davidorlian/smart-shabbat-switch/docs/project-book/Smart_Shabbat_Switch_Project_Book_HE.pdf

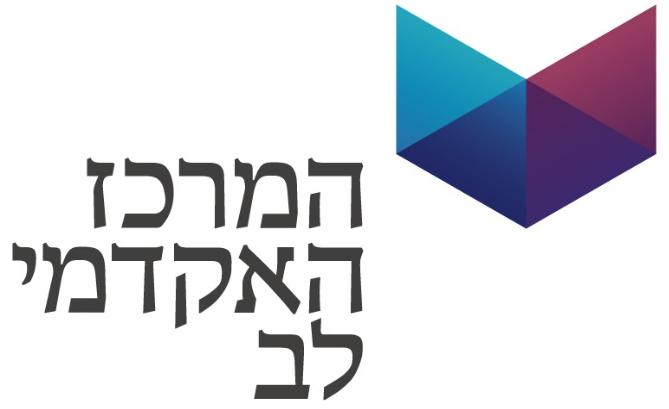
[picture p1: figure]

# הפקולטה להנדסה ומדעי המחשב

# החוג להנדסת חשמל ואלקטרוניקה

# פרויקט גמר באלקטרוניקה

# מתג שבת חכם

# Smart Shabbat Switch

## מגישים: ברק אשואל ודוד אורליאן שבט תשפ"ו מנחה: לירון בחכמה ירושלים

# תוכן עניינים

רשימת איורים 3 |
רשימת טבלאות 4 |
תקציר5 |
.1 מבוא 7 |
.2 רקע תיאורטי וסקירת ספרות 8 |
.3 פיתוח ושיטות10 |
.4 תוצאות 21 |
.5 מסקנות וסיכום 22 |
נספח א24 |
נספח ב25 |
נספח ג 26 |
מקורות 27 |

# רשימת איורים

19 | AC-DC 5V | ממיר | :3.7 | איור

# רשימת טבלאות

טבלה :3.1 רשתות מתח ואותות מרכזיים 12 |
טבלה :3.2 P328ATmega פינים בשימוש13 |
טבלה :3.3 חיבורים חיצוניים 14 |
טבלה נספח ב': תרחישי קצה 25 |

# תקציר

שימוש במתגי קיר להפעלת צרכני חשמל הוא חלק בלתי נפרד מההתנהלות היומיומית בבתים ובמרחבים ציבוריים. במצבים שונים, לחיצה מקרית על המתג )למשל ע״י ילדים, אורחים או מתוך הרגל( עלולה לשנות את מצב התאורה או המכשיר החשמלי באופן שאינו רצוי. עבור ציבור שומר י השבת, שינוי כזה במהלך השבת יוצר קושי ייחודי: הוא עלול לכפות מצב חדש, ובמהלך השבת לא ניתן לתקן את השינוי ולהחזיר את המצב לקדמותו באופן מכני. פתרונות קיימים כגון כיסויים מכניים למתגים מספקים מענה חלקי בלבד, משום שהם מצריכים התקנה והסרה ידנית בכל שבת, פוגעים באסתטיקה, ואינם מספקים חסימה אמינה לאורך זמן. מטרת פרויקט זה היא פיתוח "מתג שבת חכם" – יחידת קצה אלקטרונית המונעת שינוי לא רצוי של מצב הצרכן במהלך השבת באמצעות נעילה אלקטרונית של מתג הקיר.

המערכת שפותחה מבוססת על מיקרו־בקר ומשלבת מנגנון דגימת מצב הצרכן באמצעות מעגל חישה לנוכחות מתח רשת )AC), יחד עם שני ממסרים אלקטרומכניים. בעת קבלת פקודת מעבר למצב שבת, היחידה דוגמת את מצב הצרכן )דלוק או כבוי(, מנטרלת את השפעת מתג הקיר וקובעת את מצב ההזנה כך שהמצב שנדגם יישמר למשך מצב השבת . המתג פועל כיחידת קצה הנשלטת ע״י יחידת בקרה מרכזית, ומתקשר עם יחידת הבקרה באמצעות תקשורת אלחוטית, הכוללת מנגנון אישור קבלה )ACK )להבטחת אמינות הפקודות.

תוצאות הבדיקות הראו כי במצב שבת נשמר מצב הצרכן באופן עקבי, ללא תלות בשינויים פיזיים במתג הקיר. הן בתרחיש שבו הצרכן נכנס למצב שבת כשהוא דלוק והן כאשר נכנס כבוי, הודגם כי לחיצה על המתג במהלך השבת אינה גורמת לשינוי במצב הצרכן. בנוסף, נבחנה התנהגות המערכת במצבי קצה כגון הפסקות חשמל וחזרת מתח, ונמצא כי היחידה מתאוששת באופן צפוי ובטוח, תוך שמירה על רציפות לוגית של מצב הפעולה.

הפרויקט תורם פתרון פשוט, אמין ויישומי למניעת שינוי לא רצוי של מצב צרכן חשמלי במצב שבת באמצעות נעילה אלקטרונית פעילה. אף שהמערכת פותחה כדי להתמודד עם בעיה הלכתית לציבור שומר השבת, העיקרון ההנדסי שעליו היא מבוססת – נעילת השפעת המתג ושימור מצב הצרכן – מאפשר להכליל את הפתרון גם למצבים שבהם נדרשת יציבות תפעולית, כגון במקומות ציבוריים שבהם שינוי לא מכוון של תאורה מהווה בעיה תפקודית.

# Abstract

Wall switches are a routine way to control lighting and electrical loads in homes and public spaces. In various situations, an accidental press (e.g., by children, guests, or out of habit) can change the state of a light or appliance unintentionally. For Sabbath-observant users, such a change during Shabbat creates a unique difficulty: it may impose a new state, and the user cannot directly “undo” the change by operating the switch during Shabbat. Existing solutions such as mechanical switch covers provide only a partial answer, as they require manual installation and removal every week, affect aesthetics, and do not guarantee reliable blocking over time. The goal of this project is to develop a “Smart Shabbat Switch” – an electronic end-unit that prevents undesired changes during Shabbat by electronically locking the effect of the wall switch.

The developed system is microcontroller-based and samples the load state using an AC mains presence sensing circuit, together with two electromechanical relays. Upon receiving a command to enter Shabbat mode, the unit samples whether the load is ON or OFF, neutralizes the effect of the wall switch, and sets the supply path so that the sampled state is maintained throughout Shabbat. The switch operates as an end-unit controlled by a central control unit and communicates with it wirelessly, including an acknowledgment (ACK) mechanism to improve command reliability.

Test results showed that, in Shabbat mode, the load state is maintained consistently regardless of physical changes at the wall switch. Both when entering Shabbat mode with the load ON and when entering it with the load OFF, pressing the switch during Shabbat did not change the load state. In addition, edge cases such as power outages and power restoration were evaluated, and the unit was found to recover in a predictable and safe manner while maintaining logical continuity of its operating state.

This project delivers a simple, reliable, and practical solution for preventing undesired changes of an electrical load during Shabbat via active electronic locking. Although the system was designed to address a halachic challenge for Sabbath-observant users, its underlying engineering principle – locking the switch influence and preserving the load state – can be generalized to scenarios that require operational stability, such as public spaces where unintended lighting changes are a functional problem.

# .1 מבוא

מערכות חשמל ביתיות מהוות חלק בלתי נפרד מהתנהלות היומיום בבית המודרני. תאורה, מכשירי חשמל וצרכנים שונים מופעלים באמצעות מתגי קיר פשוטים, הנמצאים בשימוש תדיר ונגישים לכל דיירי הבית. עבור ציבור שומר י השבת, השימוש במערכות אלו מחייב תכנון מוקדם ויצירת מצב שבו פעולת החשמל נשמרת קבועה לאורך השבת, ללא צורך בהתערבות אנושית וללא שינוי בלתי רצוי של מצב המערכת .

במציאות הביתית, ובפרט בבתים שבהם מתגוררים ילדים או מתקיימת תנועת אורחים, קיים סיכון ממשי לשינוי בלתי־מכוון של מצב החשמל. ילדים עלולים ללחוץ על מתג מתוך סקרנות, משחק או חוסר מודעות, ואילו מבוגרים עשויים לשנות את מצב המתג מתוך הרגל, חוסר תשומת לב או הישענות מקרית על הקיר. פעולות אלו מתרחשות באופן טבעי ושגרתי, אך במהלך השבת הן עלולות לגרום לשינוי לא רצוי במצב התאורה או בצרכן החשמלי.

מעבר להיבט ההלכתי, מצבים אלו גורמים בעיקר לעגמת נפש ולפגיעה בכבוד השבת. שינוי פתאומי של תאורה או כיבוי מכשיר חשמלי במהלך השבת עלול להפר את האווירה השקטה והמתוכננת של היום, ליצור תחושת חוסר נוחות ולפגוע בתחושת השליטה והשלווה של בני הבית. עבור משפחות רבות, השבת אינה רק מסגרת הלכתית אלא גם זמן של רוגע, משפחתיות וכבוד, וכל תקלה או שינוי בלתי רצוי במערכת החשמל עלולים לפגוע בחוויה זו.

קיימים פתרונות פשוטים המבוססים על אמצעים מכניים, כגון תליית חוצץ פיזי או כיסוי למתג הקיר לפני כניסת השבת, במטרה למנוע לחיצה ישירה על המתג. עם זאת, פתרונות אלו מספקים מענה חלקי בלבד, שכן הם תלויים בזכירה ובהיערכות מוקדמת של המשתמש בכל ערב שבת ואינם פועלים באופן אוטונומי. בנוסף, חוצץ פיזי אינו מונע באופן מוחלט שינוי מצב המתג: ילדים עלולים לשחק בו, להסירו או להזיזו ממקומו, ואף מבוגרים עשויים להסירו מתוך חוסר תשומת לב. מגבלות אלו פוגעות באמינות הפתרון ומגבירות את הסיכון לשינוי לא מתוכנן של מצב החשמל, על כל ההשלכות הנלוות לכך.

על רקע זה, מטרת העבודה בפרויקט זה היא לפתח פתרון טכנולוגי ייעודי בדמות "מתג שבת חכם ", אשר ימנע שינוי בלתי־מכוון של מצב צרכני החשמל במהלך השבת, גם במקרה של לחיצה פיזית על מתג הקיר. המתג נועד לפעול כחלק ממערכת מתוכננת מראש, אך גם כיחידת קצה עצמאית המספקת שכבת הגנה ברורה ויעילה מפני טעויות אנוש. בכך, הפרויקט מתמקד בבעיה יומיומית ומעשית המוכרת לכל בית שומר שבת, ולא רק בהיבט תאורטי או טכני .

הפתרון שפותח במסגרת הפרויקט מבוסס על נעילה אלקטרונית של מצב המתג בזמן השבת, כך שמצב הצרכן החשמלי נשמר כפי שהיה עם כניסת השבת ואינו משתנה כתוצאה מפעולה פיזית על המתג. גישה זו מבטלת את התלות בזהירות המשתמשים או בהסברה מוקדמת לילדים ולאורחים, ומאפשרת התנהלות טבעית בבית ללא חשש מתמיד משינוי בלתי רצוי של מצב החשמל. בכך, המערכת תורמת לשמירה על רציפות השבת, על האווירה הביתית ועל כבודה של השבת, ולא רק על עמידה טכנית בכללים .

חשיבותו הציבורית של הפרויקט באה לידי ביטוי בשיפור איכות החיים של הציבור שומר השבת. המערכת מעניקה תחושת ביטחון ושקט נפשי, מפחיתה מצבי אי־ודאות ומאפשרת ניהול ביתי רגוע גם בסביבה שבה מתגי החשמל נגישים לכלל הדיירים והאורחים. היא מצמצמת מצבים של מתח, אכזבה או פגיעה באווירת השבת, ומאפשרת לבני הבית להתמקד במשמעותו הרוחנית והמשפחתית של היום .

מעבר לסביבה הביתית, ל "מתג שבת חכם" קיימת תרומה גם למרחבים ציבוריים שאינם פרטיים, כגון אולמות כנסים, אתרי אירועים, מרכזים קהילתיים ומבני ציבור. במקומות אלו מתגי חשמל ותאורה נגישים לעיתים לקהל רחב, וקיים סיכון לשינוי מצב החשמל עקב לחיצה לא מכוונת, הישענות מקרית או חוסר מודעות של משתמשים שונים. שינוי כזה עלול לגרום להפרעה לאירוע, לפגיעה ברצף הפעילות ולעגמת נפש בקרב המשתתפים. האפשרות לנעול את מצב המתג מראש מאפשרת שמירה על יציבות ורציפות תפעולית, ללא תלות בנוכחות איש תפעול סמוך לכל מתג.

לסיכום, פרויקט "מתג שבת חכם" נולד מתוך צורך ביתי וציבורי ממשי: מניעת שינוי בלתי־מכוון של מצב החשמל בסביבה שבה מתגי הקיר נגישים למשתמשים רבים. באמצעות פתרון טכנולוגי פשוט, ברור ויעיל, הפרויקט מציע מענה מעשי לבעיה יומיומית נפוצה, תורם למניעת עגמת נפש ולשמירה על כבוד השבת, ומאפשר יצירת סביבה ביתית וציבורית רגועה, מבוקרת ומכבדת יותר. בכך, הוא מדגים כיצד תכנון הנדסי רגיש יכול לתת מענה מדויק לאתגר אנושי-ערכי ולשפר באופן ממשי את חוויית החיים .

# .2 רקע תיאורטי וסקירת ספרות

## 2.1 מוצרים קיימים בשוק

### 2.1.1 מגני מתגים קיימים בשוק

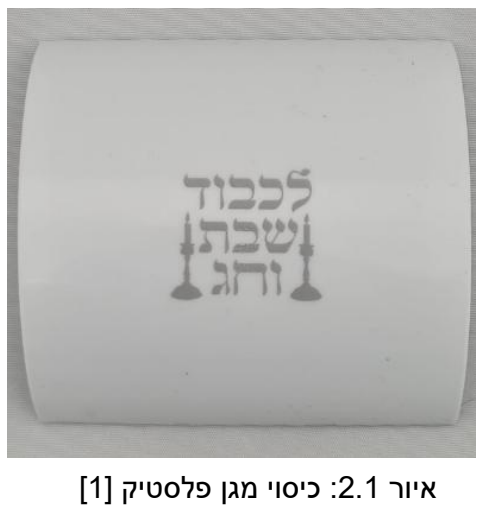
[picture p2: figure]
איור :2.1 כיסוי מגן פלסטיק ]1[

אחד הפתרונות הנפוצים והפשוטים ביותר למניעת לחיצה מקרית על מתג קיר הוא שימוש במגן מתג פיזי. בפועל, ברוב המקרים מדובר בכיסוי פלסטיק המותקן על גבי מסגרת המתג )איור 2.1( , ויוצר מחסום מכני המקטין את הנגישות הישירה ללחצן. הכיסוי מיועד למנוע לחיצה אקראית הנגרמת מהיסח דעת, משחק ילדים, או הישענות מקרית על הקיר, ובכך לצמצם שינוי לא רצוי במצב התאורה או הצרכן החשמלי המחובר.

יתרונו המרכזי של פתרון זה הוא פשטות: מדובר בהתקנה מהירה יחסית, ללא צורך בחיווט, ללא צורך בבקר, וללא שינוי במערכת החשמל הקיימת. עם זאת, מאחר שמדובר בפתרון פסיבי המבוסס על חסימה מכנית בלבד, הוא אינו "מבין" את מצב המערכת ואינו מבצע בקרה או נעילה אלקטרונית של המעגל. כלומר, הוא מנסה לצמצם את ההסתברות ללחיצה – אך אינו מבטיח שמצב הצרכן יישמר בפועל.

## 2.2 מגבלות המוצרים הקיימים

לאחר בחינת הפתרונות הרלוונטיים למניעת שינוי בלתי־מכוון של מתג קיר, ניתן להצביע על מספר מגבלות מהותיות – מגבלות שהפרויקט הנוכחי נועד לתת להן מענה ישיר.

- היערכות פיזית מבוזרת לפני שבת : פתרונות כיסוי דורשים התקנה/הצמדה פיזית לכל מתג בנפרד לפני שבת )ולעיתים גם הסרה לאחריה(. כלומר, ההגנה תלויה בטרחה חוזרת ובזכירה פר־מתג.
- אמינות מכנית מוגבלת: רכיב פלסטי נוטה לבלאי, שבר, התרופפות או נפילה לאורך זמן שימוש, ולכן אינו מספק יציבות תפעולית עקבית.
- פגיעות להתערבות משתמשים ועקיפה: הסרה אינטואיטיבית )אורחים/ילדים(, הזזה, או הפעלה " דרך " הכיסוי – מונעים מהפתרון לממש נעילה אמיתית של מצב המתג.

לאור מגבלות אלו עולה הצורך בפתרון אלקטרוני מובנה וחכם, שאינו נשען על חסימה פיזית פסיבית בלבד, אלא מבצע נעילה פונקציונלית של השפעת המתג ושומר על מצב הצרכן כפי שהיה ברגע הגדרת מצב שבת – גם אם המתג נלחץ בפועל. פתרון כזה מפחית תלות במשמעת וזהירות, וממיר את ההגנה ממנגנון "מונע לחיצה " למנגנון "מונע שינוי מצב".

## 2.3 מטרות ויעדי הפרויקט

על בסיס פערים אלו, מטרת הפרויקט המרכזית הוגדרה כדלקמן:

פיתוח יחידת "מתג שבת חכם" הניתנת לשילוב עם מתג קיר קיים, אשר מונעת שינוי בלתי -מכוון של מצב הצרכן החשמלי במהלך השבת באמצעות מנגנון נעילה אלקטרונית של השפעת המתג .

לשם מימוש מטרה זו הוגדרו יעדי הפיתוח הבאים :

- דגימת מצב נוכחי לפני נעילה: טרם מעבר למצב שבת, היחידה תדגום את מצב הצרכן כדי לקבוע מהו המצב שיש לשמר .
- שמירת מצב הצרכן לאורך השבת: המערכת תשמר את מצב הצרכן )דלוק/כבוי( כפי שהיה בעת כניסת השבת, ללא תלות במצב הפיזי של מתג הקיר במהלך השבת.
- שילוב עם יחידת שליטה מרכזית: יחידת המתג תפעל כיחידת קצה במערכת הכוללת, ותדע לקבל פקודות מצב )שבת/חול( מיחידה מרכזית )למשל "שעון שבת חכם"(, כדי לאפשר תפעול מסונכרן ונוח של כלל יחידות הקצה בבית .
- בטיחות ובידוד חשמלי: התכנון יבטיח הפרדה נאותה בין מתח הרשת למעגל הבקרה, ויעשה שימוש ברכיבים מתאימים )למשל ממסרים ובידוד אופטי(, בהתאם לעקרונות בטיחות בסיסיים במערכות מיתוג רשת .
- הקפדה על הלכות שבת :

יעדים אלו ישמשו בסיס להערכת עמידת הפרויקט במטרותיו בפרקי התוצאות והמסקנות .

# .3 פיתוח ושיטות

פרק זה מפרט את תהליך התכנון ואת שיטות המימוש שנבחרו עבור מערכת "מתג שבת חכם". התכנון ההנדסי בוצע בהתאם ליעדי הפיתוח שהוגדרו בפרק הרקע התיאורטי )פרק 2(, ובדגש על מימוש יחידת קצה קומפקטית המתאימה להתקנה בקופסת קיר ועל מנגנון שמירת מצב הצרכן בעת מעבר למצב שבת. בפרק יוצגו הבחירות המבניות והטכנולוגיות שנעשו – החל מארכיטקטורת המערכת, דרך החומרה והחיבורים החשמליים, ועד ללוגיקת התוכנה ומצבי הפעולה הייעודיים .

## 3.1 דיאגרמת בלוקים

איור 3.1 מציג את דיאגרמת הבלוקים של מערכת "מתג שבת חכם".

- במצב חול ה"מתג " פועל רגיל – "ממסר מתג" מחובר במצב (Closed Normally (NC.
- במעבר לשבת היחידה דוגמת את מצב ה"מכשיר" באמצעות "דוגם AC ".
- לאחר מכן ננעל מצב ה"מכשיר" באמצעות שני ממסרים: אחד לנטרול השפעת המתג ) " ממסר מתג "(, ואחד לקביעת מצב הצרכן החשמלי ) "ממסר שבת "(.

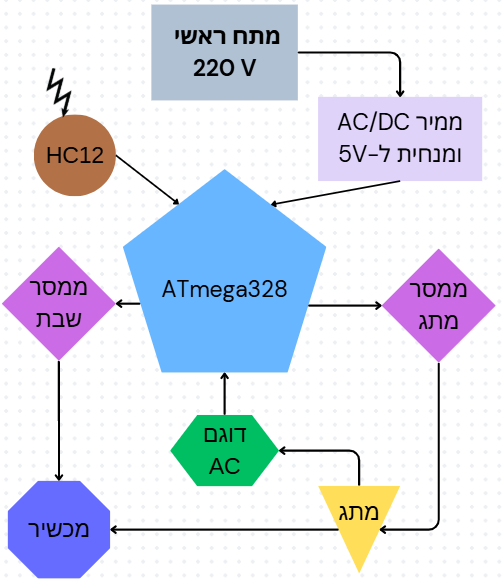
[picture p3: figure]

איור :3.1 דיאגרמת בלוקים של מערכת "מתג שבת חכם"

## 3.2 שרטוט מערכת "מתג שבת חכם"

איור 3.2 מציג את חיבורי החומרה של מערכת "מתג שבת חכם" ברמת הרכיבים. לצורך בהירות, השרטוט חולק לארבעה בלוקים: בקר P328ATmega( 1 )ומעגלי תמיכה, ספק כוח )2(, מודול תקשורת -12HC( 3 ), מודול הממסרים )4( וחיישן Sense AC( 5). האותות המרכזיים הם קווי UART לתקשורת, אות ACDetect לזיהוי מצב, ושתי יציאות שליטה לממסרים.

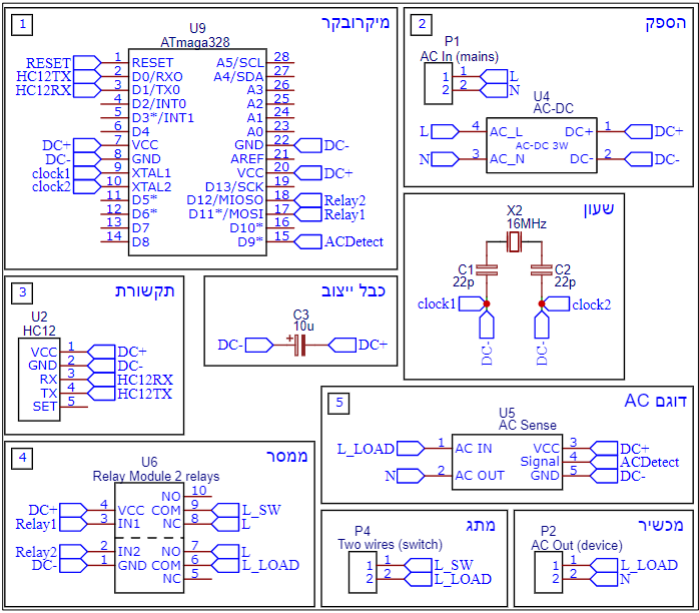
[picture p4: figure]

איור :3.2 שרטוט מערכת "מתג שבת חכם "

## 3.3 תיאור חשמלי ומיפוי חיבורים

לאחר הצגת השרטוט, מובא כאן תיאור חשמלי משלים שמפרט את החיבורים בפועל: מהיכן מתקבל כל מתח וכל אות, לאן הם מתחברים, ומה תפקידם במערכת.

### 3.3.1 רשתות מתח ואותות מרכזי ים

טבלה 3.1 מציגה את רשתות המתח והאותות העיקריים במערכת. לכל רשת מצוינים סוג הרשת )מתח רשת VAC,230 מתח DC, או אות לוגי(, מקור ההזנה/האות, והרכיבים אליהם היא מחוברת. ריכוז זה מאפשר להבין בקלות את מסלול י הזנת המערכת ואת הקשרים המרכזיים בין בלוקי החומרה.

| | | | Signal / Net רמת מתח / סוג מקור צרכנים הערות
פאזה נכנסת למערכת | AC-DC (AC_L), Relay Module (COM) | Mains (1) | ) פאזה )230VAC | L
אפס משותף )לא ממותג( | AC-DC (AC_N), Device (2), AC Sense (AC OUT) | Mains (2) | )אפס )230VAC | N
מסילת הזנה | ATmega (VCC), HC-12 (VCC), Relay Module (VCC), AC Sense (VCC) | AC-DC (DC+) | )ספק )+5VDC | DC+
אדמה משותפת | ATmega (GND), HC-12 (GND), Relay Module (GND), AC Sense (GND) | AC-DC (DC-) | 0V (GND) | DC-
למתג פאזה | Switch (1) | )OUT( Relay1 מגע | ( למתג קו )230VAC | L_SW
פאזה לצרכן וגם לנדגם | Device (1), AC Sense (AC IN), Switch (2) | ,)OUT( Realy2 מגע Switch (2) | קו )230VAC / לדוגם( | L_LOAD לצרכן
| ATmega (D9) | AC Sense (Signal) | (0/5V) Active-low | ACDetect Digital input
TX→RX | ATmega (RXD) | HC-12 (TX) | UART (TTL 0/5V) | HC12TX
TX→RX | HC-12 (RX) | ATmega (TXD) | UART (TTL 0/5V) | HC12RX
שליטת Relay1 | | ATmega (D11) | (0/5V) Relay Module (IN2) | Relay1 Digital output
שליטת Relay2 | | ATmega (D12) | (0/5V) Relay Module (IN1) | Relay2 Digital output
R1=10k | ATmega (RESET) | Pull-up (DC+) | Reset (active-low) | RESET

טבלה :3.1 רשתות מתח ואותות מרכזיים

### 3.3.2 מיפוי פיני הבקר )P328ATmega )שבשימוש

טבלה 3.2 מפרטת את פיני ה מיקרו-בקר שבשימוש במערכת, יחד עם הרשת אליה מחובר כל פין ותפקידו. הפירוט כולל את קווי התקשורת )UART )למודול -12HC, יציאות הבקרה לממסרים, כניסת זיהוי המתח, וכן פיני ההזנה והאיפוס. מיפוי זה מקשר באופן ישיר בין השרטוט לבין מימוש החומרה והתוכנה.

| | | Net מחובר ל... תפקיד הערות | פין במיקרו )שם / מספר(
Pull-up 10k | איפוס | DC+-ל R pull-up | RESET | RESET (Pin 1) טיפוסי
TX→RX | UART RX | HC-12 TX | HC12TX | RXD (Pin 2)
TX→RX | UART TX | HC-12 RX | HC12RX | TXD (Pin 3)
5V | מיקרו הזנת | U12 יציאת | DC+ | VCC (Pin 7)
| אדמה | U12 יציאת | DC- | GND (Pin 8)
| שעון | Crystal X2 | Clock1 | XTAL1 (Pin 9)
| שעון | Crystal X2 | Clock2 | XTAL2 (Pin 10)
| קלט זיהוי מתח Low Active | Detector | ACDetect | D9 (Pin 15) AC של Signal
דיגיטלית יציאה | מתג עקיפת | Relay Module של IN2 | Relay1 | D11 (Pin 17)
| | | | (18 Pin (12D 2Relay 1IN של Module Relay שליטה על עומס יציאה דיגיטלית
5V | נוספת הזנה | U12 יציאת | DC+ | VCC (Pin 20)
| נוספת אדמה | U12 יציאת | DC- | GND (Pin 22)

טבלה :3.2 P328ATmega פינים בשימוש

### 3.3.3 חיבורים חיצוניים )מחברים(

בחיבורי מתג קיר קיימים שני מוליכים: פאזה מוזנת למתג )צד הכניסה של המתג(, ופאזה ממותגת היוצאת מהמתג אל הצרכן. במערכת הנוכחית הפאזה המוזנת למתג אינה מגיעה ישירות מלוח החשמל, אלא מתקבלת דרך "ממסר מתג" )1Relay), ומסומנת כחיבור 1-1H. הפאזה היוצאת מהמתג לכיוון הצרכן מסומנת כחיבור 1-2H, והיא משמשת גם כקו הנדגם על -ידי מעגל Sense AC לצורך קביעת מצב הצרכן בעת מעבר למצב שבת )LOAD_L ).

| | | | מחבר טרמינל רשת לאן הולך פיזית תפקיד
| | | | (IN AC (1P 1 L פאזה מהרשת הזנת המערכת
| | | | (IN AC (1P 2 N אפס מהרשת הזנת המערכת
לעומס פאזה | ( L_LOAD צומת ) לצרכן פאזה | L_LOAD | 1 | P2 (AC OUT)
| | | | (OUT AC (2P 2 N אפס לצרכן )ישיר( אפס לא מבוקר
| | | | (Switch (1H 1 SW_L פאזה שנכנסת למתג )מ 1-Relay )כניסת מתג
| | | | (Switch (1H 2 LOAD_L יציאת מתג לצרכן + לדוגם AC יציאת מתג / קו נדגם

טבלה :3.3 חיבורים חיצוניים

## 3.4 רכיבים

### 3.4.1 P328ATmega – מיקרו־בקר לבקרת מערכות משובצות

תיאור כללי:
ה-P328ATmega הוא מיקרו־בקר ממשפחת AVR של Microchip( לשעבר Atmel), הנפוץ במיוחד בלוחות Uno Arduino ודומיהם. הוא מבוסס על ארכיטקטורת 8 ביט מסוג RISC, המאפשרת ביצועים גבוהים וצריכת הספק נמוכה. המיקרו־בקר משלב זיכרון Flash לתוכנית, זיכרון SRAM לעיבוד נתונים ו־ EEPROM לאחסון נתונים לא־נדיפים, וכן מגוון רחב של ממשקי תקשורת וכניסות/יציאות דיגיטליות ואנלוגיות.

עקרון פעולה:
הבקר פועל על פי קוד תוכנה המאוחסן בזיכרון הפנימי ומבצע הוראות בהתאם לתדר השעון . באמצעות פקודות תוכנה ניתן לשלוט בממשקי GPIO, לקרוא נתונים מחיישנים אנלוגיים, ולהפעיל התקנים חיצוניים דרך פרוטוקולים .I²C (TWI)ו־ UART, SPI כמו

השימוש בפרויקט שלנו:
ה-P328ATmega משמש כבקר של יחידת ה"מתג שבת חכם". הוא מתפקד יחידת קצה (Node (המקבלת פקודות מהבקר המרכזי, ואחראי למימוש לוגיקת מצב שבת . מיקרו-בקר זה קל לתכנות ומספק מספיק פיני Ο\I, בעוד הוא מאפשר לנו לשמור על מערכת קטנה כך שתוכל להשתלב בתוך קופסה בקיר.

תיאור פינים עיקריים:
- GND / VCC – הזנת מתח והארקה.
.)GPIO ( | דיגיטליים | פלט/קלט | קווי | – PC0–PC5, PD0–PD7 | •
- RESET – איפוס הבקר.
- 2XTAL / 1XTAL – חיבור לקריסטל חיצוני )MHz16).
. | סיריאלית | UART | תקשורת | – RX / TX (PD0 / PD1) | •

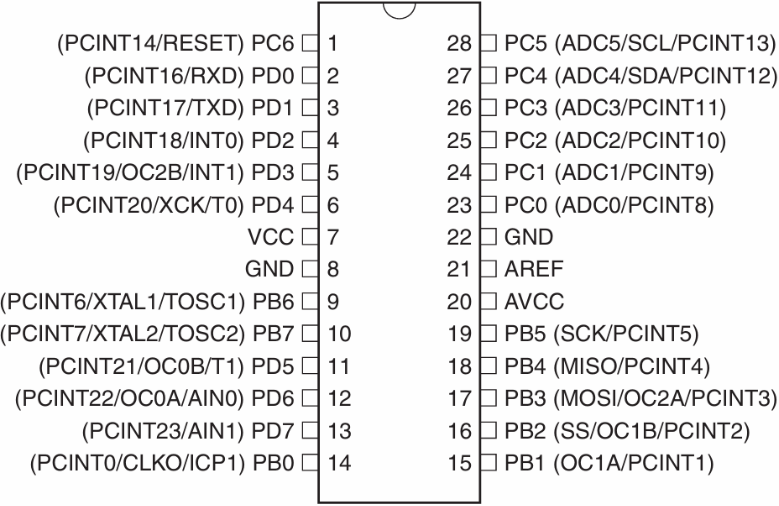
[picture p5: figure]

איור :3.3 תרשים פינים ]2[

### 3.4.2 -12HC – מודול תקשורת אלחוטית לטווח ארוך

תיאור כללי:
ה-12-HC הוא מודול תקשורת אלחוטית חזק ואמין העובד בתדר MHz.433 המודול מאפשר תקשורת דו־כיוונית בין שני מיקרו־בקרים באמצעות ממשק (Serial (UART רגיל. הוא מבוסס על שבב 4463SI של חברת Silicon Labs, ומיועד להעברת נתונים למרחקים של עד 1 ק"מ בקו ראייה, בהתאם לעוצמת השידור והאנטנה.

עקרון פעולה:
המודול מתפקד כמעין "כבל סיריאלי אלחוטי" – כל מידע הנשלח דרך UART מצד אחד מתקבל אוטומטית במודול השני, ללא צורך בפרוטוקול תקשורת נוסף. ניתן להגדיר את המודול למגוון מצבים באמצעות פקודות AT, כגון מהירות שידור )Rate Baud), עוצמת שידור וערוץ עבודה )תדר(.

השימוש בפרויקט שלנו:
מודול ה -12-HC משמש לתקשורת בין היחידה הראשית לבין יחידת הקצה – "מתג שבת חכם" . הבקר של המתג מקבל באמצעות ה-12-HC פקודות )week / shabbat )מהיחידה הראשית. בהתאם לפקודה שהתקבלה, הבקר מפעיל את לוגיקת מצב שבת ומעדכן את מצב הממסרים. באופן זה מתאפשר תיאום בין שני היחידה הראשית ליחידת הקצה גם ללא חיבור לרשת Fi-Wi מקומית.

תיאור פינים עיקריים:
- VCC – הזנת מתח פעולה )V-5.5V3.2).
- GND – הארקה.
- TXD – פלט סיריאלי )מתחבר ל -RX של המיקרו- בקר(.
- RXD – קלט סיריאלי )מתחבר ל -TX של המיקרו -בקר(.
- SET – כניסה לתכנות באמצעות פקודות AT( כאשר נמשך ל -LOW).

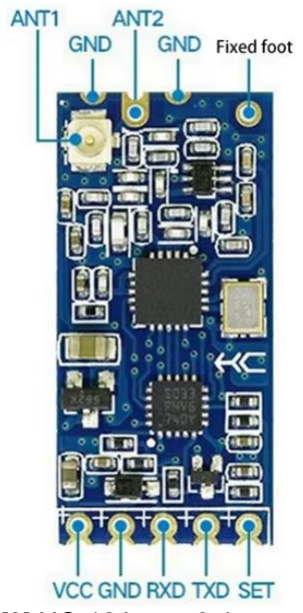
[picture p6: figure]

איור :3.4 מודול -12HC[ 3 ]

### 3.4.3 Circuit Sense AC – מעגל דגימת מתח

תיאור כללי:
ה-Sense AC הוא מעגל זיהוי נוכחות מתח רשת במעגל מסוים. המעגל מבוסס על מבודד אופטי ) Optocoupler), המאפשר להעביר מידע על קיום מתח בצורה בטוחה תוך בידוד גלווני בין מתח הרשת למעגל הבקרה.

עקרון פעולה:
כאשר קיים מתח AC בקו הנמדד, זורם זרם דרך צד ה LED-במבודד האופטי )באמצעות רכיבי הגבלת זרם/יישור בתכן(, ומופעל הפוטו-טרנזיסטור בצד המשני. הטרנזיסטור יוצר אות לוגי למיקרו -בקר, המשקף את מצב המתח במעגל – "0" לוגי כאשר יש מתח, ו- "1" כאשר אין.

השימוש בפרויקט שלנו:
מעגל ה-Sense AC משמש את ה"מתג שבת חכם " לזיהוי מצב המתג בעת קבלת פקודת "מצב שבת" )shabbat ). המעגל מזהה האם קיימת נוכחות מתח ביציאת המתג , והמידע משמש את הבקר כדי לשלוט על מצבי הממסרים כך שמצב המכשיר המחובר )דלוק או כבוי( יישמר קבוע לאורך כל השבת.

תיאור חיבורים עיקריים:
- L – כניסה מיציאת המתג הידני )קו פאזה הנדגם(.
- N – חיבור לאפס של רשת החשמל.
- OUT – פלט דיגיטלי למיקרו- בקר )LOW כאשר מזוהה מתח(.
- GND / VCC – הזנת מתח לצד הבקרה.

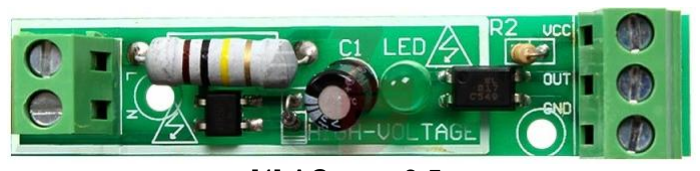
[picture p7: figure]

איור :3.5 דוגם AC[ 4 ]

### 3.4.4 Module Relay – ממסר אלקטרומכני למיתוג צרכני חשמל

תיאור כללי:
הממסר הוא רכיב אלקטרומכני המשמש כמפסק חשמלי המופעל על ידי אות בקרה. הוא מאפשר למיקרו־בקר )כמו P328ATmega )לשלוט במעגלי זרם גבוה או במתח רשת, תוך בידוד גלווני בין צד הבקרה לצד הצרכן החשמלי, בהתאם לתכן המודול . במודולים נפוצים משולב מבודד אופטי (Optocoupler(, דיודת הגנה )Diode Flyback ) ונוריות חיווי, ובכך מתאפשרת הפעלה נוחה באמצעות יציאה דיגיטלית, בהתאם למפרט המודול .

עקרון פעולה:
כאשר המיקרו־בקר משנה את אות הבקרה )LOW/HIGH בהתאם למודול( , זרם הפעלה זורם בסליל המגנטי, וגורם לסגירת המגעים )או פתיחתם, בהתאם לסוג(. בצורה זו ניתן להדליק או לכבות צרכן חשמלי חיצוני – לדוגמה, תאורה או מכשיר חשמלי – באמצעות שליטה דיגיטלית פשוטה.

השימוש בפרויקט שלנו:
לאחר בחינת מספר אפשרויות שונות למימוש הלוגיקה הנדרשת למערכת בפרויקט זה , נעשה שימוש במודול הכולל שני ממסרים. מודול כזה מאפשר לממש את לוגיקת ה"מתג שבת חכם" בצורה מלאה: עקיפת המתג הידני, ונעילת מצב הצרכן החשמלי.

תיאור פינים עיקריים:
- VCC – מתח הזנה )V5).
- GND – הארקה.
- IN – כניסת אות בקרה מהמיקרו־בקר )HIGH-Active או LOW-Active).
- COM – מגע משותף למיתוג הצרכן החשמלי .
- (Open Normally (NO – מגע פתוח במצב מנוחה, נסגר בהפעלה.
- (Closed Normally (NC – מגע סגור במצב מנוחה, נפתח בהפעלה.

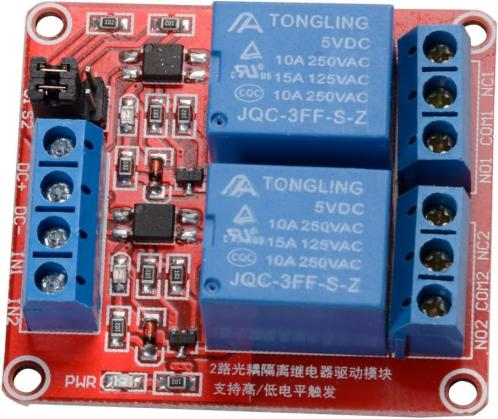
[picture p8: figure]

איור :3.6 מודול ממסר אלקטרומכני ] 5[

### 3.4.5 Converter DC-AC – ממיר מתח לרכיבי בקרה

תיאור כללי:
ממיר ה-DC-AC משמש להמרת מתח הרשת )AC V230 )למתח ישר נמוך )בדרך כלל DC V5 או DC V3.3 ) המתאים להזנת המיקרו -בקר ושאר רכיבי הבקרה במערכת. מדובר במודול DC-AC קומפקטי הכולל מעגלי יישור, סינון וייצוב מתח, ומאפשר חיבור ישיר למתח הרשת תוך שמירה על בידוד חשמלי בידוד גלווני בין צד הרשת לצד ה־ ,DCבהתאם למפרט הממיר.

עקרון פעולה:
הממיר מבצע יישור והמרה ממותגת פנימית (SMPS (ליצירת מתח DC מיוצב. הממיר כולל בידוד גלווני בין כניסת הרשת לבין יציאת ה -DC, ומספק מתח יציב להזנת ה -P328ATmega, מודולי התקשורת והממסרים.

השימוש בפרויקט שלנו:
הממיר משמש להזנת ה- P328ATmega וכל שאר רכיבי הבקרה במתח DC V.5 הוא מאפשר חיבור ישיר של המערכת לרשת החשמל , תוך שמירה על בטיחות ובידוד מלא. כך נשמרת אספקת מתח יציבה לכל ל הרכיבים. רכיב זה מאפשר לחבר את רשת החשמל למערכת בצורה קלה וכזו השומרת על גודל קטן של המערכת.

תיאור חיבורים עיקריים:
.) | ואפס | פאזה | )230V AC | רשת | מתח | כניסת | – AC IN (L/N) | •
.5V DC | ישר | מתח | יציאת | ( – + )DC OUT | •
- OUT DC – )–( הארקת יציאה.

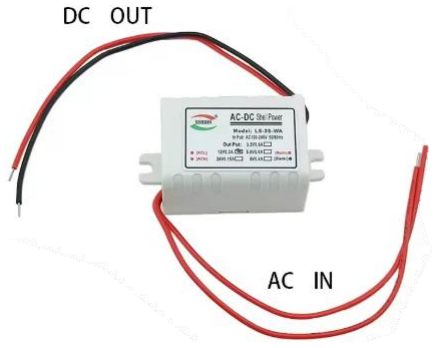
[picture p9: figure]

]6[ AC-DC 5V | ממיר | :3.7 | איור

### 3.4.6 הצדקת בחירת רכיבי חומרה מרכזיים

לצורך עמידה בדרישות הפרויקט נבחרה ארכיטקטורה המחלקת את המערכת ליחידה מרכזית ויחידת קצה המותקנת בקופסת קיר. בבקר יחידת הקצה נבחר P328ATmega בשל פשטות מימוש, זמינות גבוהה ויכולת שליטה ישירה בקווי O/I ובממסרים. לצורך תקשורת אלחוטית פשוטה ואמינה נבחר מודול -12HC, המאפשר פקודות שליטה ללא תלות ברשת Fi-Wi בסביבת המתג . שמירת מצב הצרכן במעבר למצב שבת מבוצעת באמצעות דגימה של נוכחות מתח )Sense AC )תוך שמירה על בידוד חשמלי באמצעות אופטוקופלר. הזנת המערכת מבוצעת באמצעות ספק DC-AC מבודד, שנבחר על מנת לאפשר אינטגרציה קומפקטית ובטוחה בתוך קופסת קיר .

## 3.5 תוכנות שפותחו

במערכת "מתג שבת חכם" פותחה קושחה האחראית ללוגיקת מצב שבת, לדגימת מצב הצרכן החשמלי ולשליטה בממסרים בהתאם לפקודות המתקבלות מהיחידה המרכזית.

### 3.5.1 קושחת "מתג שבת חכם" ) Switch Shabbat Smart )

הקושחה מאזינה לפקודות מצב מהיחידה המרכזית דרך -12HC.

### 3.5.2 ממשק אינטרנטי למשתמש )Interface Web)

הגדרת לוח הזמנים ומצב שבת/חול מבוצעת בממשק Web ביחידה המרכזית. יחידת המתג מקבלת את פקודות המצב באמצעות -12HC ומבצעת אותן מקומית.

## 3.6 מבנה המערכת

### 3.6.1 ארכיטקטורת המערכת ותקשורת בין יחידות

המערכת מציעה ארכיטקטורה היררכית המהווה מענה לצורך בבקרה מרכזית ובתקשורת בין יחידות. יחידת ה"מתג שבת חכם" היא יחידת קצה המקבלת פקודות מיחידה מרכזית באמצעות (-12HC (RF.

- שליטה מרוכזת: יחידת המתג מקבלת פקודת מצב שבת/חול ומפעילה נעילה מקומית של המתג. לדוגמה, ניתן בלחיצת כפתור להעביר בבת אחת את כל יחידות הקצה למצב שבת – מצב המונע את שינוי מצב המתגים – ובצאת השבת להחזיר את כולן למצב רגיל.
- תקשורת דו-כיוונית: המערכת מבצעת אימות פקודה באמצעות (acknowledgement (ACK: לכל פקודה שנשלחת מהיחידה המרכזית, יחידת המתג משיבה ACK. אי־קבלת ACK בתוך פסק זמן מוגדר מסווגת את הפעולה ככושלת ו בכך מצביעה על בעיית תקשורת/חיבור. במצב כזה לא יתאפשר מעבר למצב שבת.

### 3.6.2 מימוש התאמה הלכתית ומצב שבת אוטומטי

הפרויקט מיועד לעמוד ביעד של התאמה מובנית למסגרת ההלכתית באמצעות שילוב מצב פעולה ייעודי:

מצב שבת )Mode Shabbat): בעת מעבר למצב שבת , היחידה המרכזית שולחת לכל המתגים פקודת מעבר ל"מצב שבת ". המצב נקבע על סמך דגימת ה-Sense AC טרם נעילת המתג. מצב הממסרים נקבע וננעל כך שהצרכן החשמלי נשמר כפי שנדגם לפני המעבר למצב שבת )דלוק/כבוי( לאורך השבת. גישה זו מממשת נעילה אלקטרונית של המתג ובכך מבטלת שינוי לא־מכוון.

# .4 תוצאות

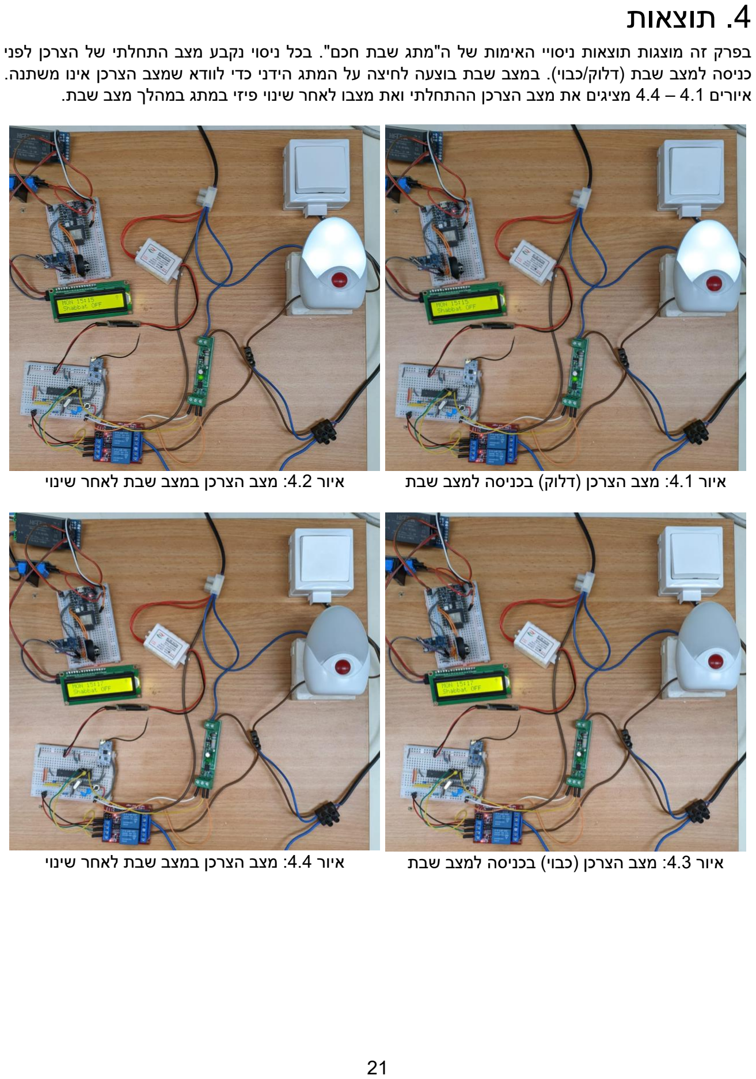
[picture p10: page 21]

בפרק זה מוצגות תוצאות ניסויי האימות של ה"מתג שבת חכם". בכל ניסוי נקבע מצב התחלתי של הצרכן לפני כניסה למצב שבת )דלוק/כבוי(. במצב שבת בוצעה לחיצה על המתג הידני כדי לוודא שמצב הצרכן אינו משתנה. איורים 4.1 – 4.4 מציגים את מצב הצרכן ההתחלתי ואת מצבו לאחר שינוי פיזי במתג במהלך מצב שבת.

איור :4.1 מצב הצרכן )דלוק( בכניסה למצב שבת איור :4.2 מצב הצרכן במצב שבת לאחר שינוי

איור :4.3 מצב הצרכן )כבוי( בכניסה למצב שבת איור :4.4 מצב הצרכן במצב שבת לאחר שינוי

# .5 מסקנות וסיכום

פרק זה מסכם ומעריך באופן ביקורתי את עבודת הפרויקט מראשיתה ועד סופה. הוא מנתח את רמת העמידה במטרות שנקבעו, מציע הסברים לתוצאות שהושגו ומציג כיווני פיתוח עתידיים.

## 5.1 עמידה במטרות הפרויקט והערכה ביקורתית

מטרת הפרויקט הנוכחי הייתה פיתוח יחידת "מתג שבת חכם" – מודול אלקטרוני הניתן להוספה למתג קיר קיים, המממש פקודות מצב/נעילה המתקבלות מיחידה מרכזית. במסגרת זו נבחנו היתכנות אלקטרונית, בטיחותית והלכתית של פתרון עקיפת המתג ושימור מצב המכשיר לאורך השבת .

המערכת עמדה ביעדי הפיתוח שהוגדרו במסגרת הפרויקט. המימוש ההנדסי של הארכיטקטורה הדו- רכיבית – הכוללת יחידת שעון מרכזי )מבוסס 32ESP )ויחידות מתג קצה )מבוסס P328ATmega – )הוכח כיציב, פונקציונלי ומספק מענה ליעדי הפיתוח שהוגדרו בסעיף 3.3 בפרק "רקע תיאורטי וסקירת ספרות" :

- בקרה מרכזית ותקשורת בין יחידות : יעד זה מומש בהצלחה באמצעות פרוטוקול התקשורת האלחוטית RF בין יחידת השעון המרכזית למתגים המרוחקים. יכולת זו מאפשרת סנכרון של כלל המתגים מרחוק ובלחיצת כפתור אחת, מבצעת תיאום מצב מול יחידה מרכזית ומאפשרת זיהוי חוסר תגובה באמצעות .ACK
- מימוש מצב שבת ושימור מצב הצרכן: בעת מעבר למצב שבת יחידת המתג דוגמת את מצב הצרכן החשמלי באמצעות Sense AC, מגדירה את מצב שני הממסרים ונועלת את השפעת המתג הידני כך
שמצב הצרכן נשמר לאורך השבת. בבדיקות המערכת הודגם כי שינוי פיזי במתג הידני לאחר המעבר למצב
שבת אינו משנה את מצב הצרכן, הן כאשר נכנס דלוק והן כאשר נכנס כבוי.

לסיכום, מערכת "מתג שבת חכם" מדגימה פתרון עקיפה ונעילה המבוסס P328ATmega, שני ממסרים ומעגל AC Sense, ומאפשרת פעולה מתואמת מול יחידת בקרה מרכזית.

## 5.2 שיפורים אפשריים והרחבה עתידית

על אף הצלחת המימוש של המערכת, קיימים מספר כיוונים ושיפורים שאפשר לממש לעתיד כדי להעלות את רמת הפרויקט ולספק ערך מוסף:

### 5.2.1 שיפורים במימוש הנוכחי ) Improvements Immediate )

במימוש הנוכחי יחידת הקצה בנויה ממספר מודולים מוכנים, ולכן למרות שהמערכת עובדת היטב, הנפח הפיזי והמורכבות המכאנית עדיין אינם מיטביים להתקנה נקייה בתוך קופסת קיר. שיפור מיידי ומתבקש הוא מעבר לאינטגרציה חומרתית באמצעות בחירה מחודשת של רכיבים ותכנון PCB ייעודי. כרטיס ייעודי יאפשר לאחד על גבי לוח אחד את רכיבי הבקרה, התקשורת ומעגלי החישה וההפעלה, לצמצם חיווט ומחברים, ולהתאים את המערכת באופן מדויק לדרישות הפונקציונליות של "מתג שבת חכם ". בנוסף, תכנון PCB יאפשר לתכנן מראש מרחקי בידוד ובטיחות, ולשפר אמינות ויכולת ייצ ור/הרכבה.

### 5.2.2 הרחבות למערכות עתידיות ) Scope Future )

הרחבה עתידית מרכזית היא תמיכה במערכת מרובת יחידות קצה, שבה כל יחידה מקבלת זהות קבועה וניתנת לניהול אישי – תוך שימוש בערוץ תקשורת משותף אחד, ללא חלוקת תדרים וללא תכנות ידני של מזהים מראש. לשם כך נעשה שימוש במנגנון "זיווג" )Pairing )אוטומטי: יחידה חדשה שמזהה שאין לה מזהה שמור נכנסת למצב זיווג מוגבל בזמן עם חיווי לד, ואם לא הוגדרה – עוברת למצב האזנה בלבד כדי לצמצם עומס ושידורים מיותרים. תהליך ההגדרה מתבצע מצד הבקר המרכזי באמצעות פקודת סריקה כללית שמחזירה יחידות לא מזוהות למצב זיווג, ולאחר מכן זיהוי פיזי באמצעות פקודה ליחידה ספציפית. לאחר שהמשתמש מאשר שזו היחידה הרצויה, מוקצה לה מזהה קבוע הנשמר בזיכרון הלא־נדיף, ומאותו רגע היחידה מגיבה רק לפקודות ממוענות אליה או לפקודות כלליות. כך נוצר הפרדה לוגית על גבי אותו ערוץ תקשורת, המאפשר תפקוד הדומה למערכת רב־ערוצית – ללא צורך במורכבות חומרתית או בהקצאת תדרים נפרדת.

## 5.3 תרומת הפרויקט

פרויקט "מתג שבת חכם" מציג תרומה כפולה:

.1 תרומה טכנולוגית: הפרויקט מדגים מימוש של יחידת קצה – "מתג שבת חכם" – המוסיפה למתג קיר קיים מנגנון נעילה אלקטרונית המבוסס על P328ATmega, שני ממסרים ומעגל Sense AC. היחידה דוגמת את מצב הצרכן החשמלי לפני מעבר למצב שבת, מגדירה את מצב הממסרים בהתאם, ושומרת על מצב הצרכן גם במקרה של שינוי פיזי במתג הידני. בנוסף, הודגם מנגנון תקשורת RF פשוט בין יחידת הקצה ליחידה המרכזית, הכולל אישור קבלה )ACK )לזיהוי קבלת פקודות וחוסר תגובה.

.2 תרומה ציבורית/הלכתית : הפרויקט מהווה פתרון ממוקד, בטוח ונגיש לבעיית השליטה באוטומציה ביתית עבור הציבור שומר השבת. הוא מפשט את התפעול, מגביר את רמת הדיוק ומבטיח את עקרון מניעת חילול שבת בטעות באמצעות נעילה אלקטרונית מובנית, ובכך משפר את איכות החיים והביטחון ההלכתי של המשתמשים.

# נספח א

## התנהגות המערכת בעת הפסקת חשמל וחזרת מתח

מתג השבת החכם הוא יחידת קצה שמטרתה לשמר מצב פעולה יציב במכשיר המחובר, ובפרט במצב שבת שבו יש צורך לעקוף את השפעת המתג המקומי. בזמן הפסקת חשמל היחידה נכבית, והממסרים מאבדים מתח. כאשר החשמל חוזר, היחידה מבצעת אתחול מחדש ומתחילה ממצב ברירת מחדל בטוח )מצב ”חול“(, כדי למנוע כניסה לא מכוונת לעקיפה ללא הקשר.

במקביל, כדי לשפר שרידות והתנהגות צפויה לאחר הפסקות חשמל, היחידה שומרת בזיכרון לא נדיף את מצב הממסרים האחרון. כך, אם לפני הכיבוי היחידה הייתה במצב שבת )עקיפה פעילה( או במצב חול, לאחר חזרת המתח היא יכולה לשחזר את המצב האחרון ולהמשיך באותה התנהגות, ללא תלות מיידית בתקשורת עם השעון. השחזור המקומי מקטין תלות ברשת ומאפשר עמידות גבוהה יותר בתרחישים שבהם יחידת הקצה חווה הפסקת חשמל מקומית בעוד השעון ממשיך לפעול, או להפך .

כאשר היחידה מקבלת פקודות מהשעון )שבת/חול(, היא מיישמת את הפקודה ומשמרת את המצב החדש בזיכרון הלא נדיף. במעבר למצב שבת היא משתמשת בחיווי מצב )לדוגמה, חיישן מצב עומס/מתח( כדי לקבע את מצב המכשיר כך שהשפעת המתג המקומי תנוטרל, והמצב יישאר יציב לאורך השבת. בדרך זו, ההתנהגות לאחר הפסקת חשמל נשארת עקבית עם ההחלטה האחרונה שניתנה למתג, ומתיישבת עם מטרת יחידת הקצה: יציבות ורציפות מצב.

# נספח ב

## תרחישי קצה ובדיקות מערכת

| | | תנאי התחלה אירוע/פעולה תוצאה צפויה הערה )למה זה חשוב(
כניסה אמינה למצב שבת | המתג מפעיל עקיפה ומקבע את מצב המכשיר; נשלח ACK | "שבת " מהשעון | מצב חול מתקבלת פקודת
יציאה נקייה ממצב שבת | המתג מבטל עקיפה וחוזר להתנהגות רגילה; נשלח ACK | "חול" מהשעון | מצב שבת מתקבלת פקודת
שרידות יחידת קצה ללא תלות מיידית בשעון | המתג משחזר את מצב השבת מהזיכרון הלא־נדיף )נשאר שבת( | למתג וחזרת מתח | מצב שבת הפסקת חשמל
reboot | המתג נשאר חול )שחזור מצב( עקביות התנהגות אחרי | למתג וחזרת מתח | מצב חול הפסקת חשמל
התנהגות צפויה במוצר חדש | חול | חזרת מתח המתג נכנס לברירת מחדל בטוחה: | הפעלה ראשונה / זיכרון לא מאותחל
חסינות לרעש/חוסר יציבות בכניסות | המתג מקבל החלטה עקבית ולא "מתהפך" באופן אקראי | כניסה לשבת בזמן מדידה לא יציבה | מצב שבת; חיווי מצב המכשיר גבולי/רועש
אמינות תחת תקשורת לא מושלמת | המתג מגיב בצורה דטרמיניסטית; לא נוצר מצב ביניים; ACK עקבי | מתקבלות פקודות חוזרות | תקשורת לא יציבה )כפילויות/עיכובים(
שליטה מקומית במקרי קיצון | המדיניות | לחיצה בזמן שבת המתג חוזר לחול באופן מיידי לפי | לחצן Override( אם קיים(
יציבות מכנית/לוגית | הריליים תמיד במצב מוגדר, ללא "מצב ביניים" | מעברים רבים שבת↔חול | עבודה רציפה לאורך זמן

טבלה נספח ב': תרחישי קצה

# נספח ג

## סכמות חיווט – השלמה לתרשים הבלוקים )פרק 3(

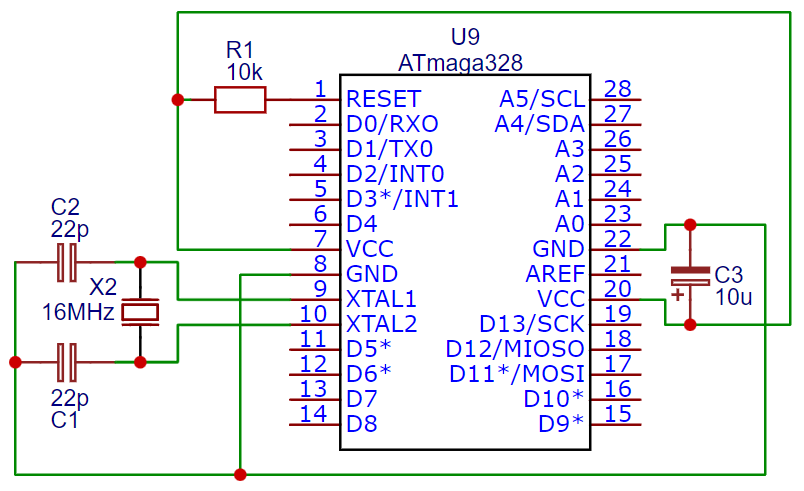
[picture p11: figure]

איור ג:1. חיווט ותצורת עבודה של Reset (P328ATmega, קריסטל 16MHz וקבלי ייצוב(.

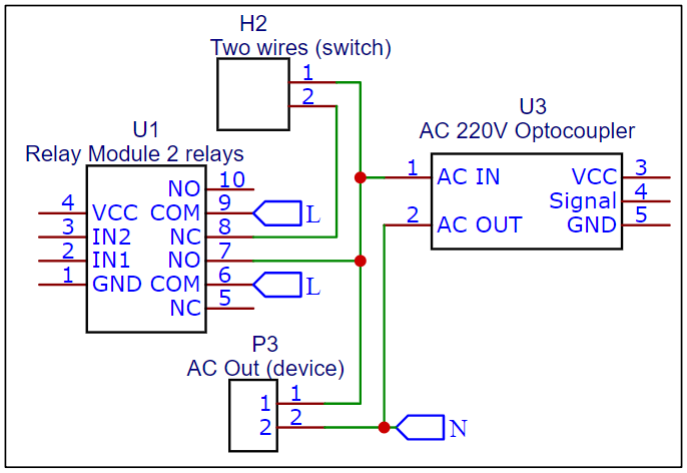
[picture p12: figure]

איור ג:2. חיווט שכבת המיתוג והחישה )ממסרים + חיישן AC מבודד אופטי(.

# מקורות

[1] Koretzki.co.il. [Online]. Available: https://www.koretzki.co.il/product/%D7%97%D7%9E%D7%99%D7%A9%D7%99%D7%99 %D7%AA-%D7%9E%D7%92%D7%9F-%D7%A9%D7%A7%D7%A2-%D7%9C%D7%A9%D7%91%D7%AA-%E2%80%93-%D7%9B%D7%99%D7%A1%D7%95%D7%99-%D7%9E%D7%AA%D7%92-%D7%90%D7%95%D7%A0%D7%99%D7%91%D7%A8%D7%A1%D7%9C%D7%99. [Accessed: 28-Jan-2026].
[2] Microchip.com. [Online]. Available: https://ww1.microchip.com/downloads/aemDocuments/documents/MCU08/ProductDocuments/DataSheets/ATmega48A-PA-88A-PA-168A-PA-328-P-DS-DS40002061B.pdf. [Accessed: 28-Jan-2026].
[3] “4X HC-12 433Mhz SI4463 Wireless Serial Port Module 1000M Replace Bluetooth HC12 -AliExpress 44,” aliexpress. [Online]. Available: https://he.aliexpress.com/item/1005005101377869.html. [Accessed: 28-Jan-2026].
[4] “1 Channel AC 220V Optocoupler Isolation PLC Module Optocoupler Isolation Drive Module Optocoupler Isolation Test Board Module,” aliexpress. [Online]. Available: https://he.aliexpress.com/i/1005004340194831.html?gatewayAdapt=glo2isr. [Accessed: 28-Jan-2026].
[5] 2 pcs 5V 2 channel DC 5V relay module with optocoupler high/low level trigger expansion board. .
[6] “AC to DC Converter Step-down Power Supply Module AC110V 220V 230V To DC 3V 5V 9V 12V 15V 24V 3W Led Isolated Voltage Stabilized - AliExpress 13,” aliexpress. [Online]. Available: https://he.aliexpress.com/item/1005005945688332.html. [Accessed: 28-Jan-2026].
