davidorlian/smart-shabbat-switch/(commit log)

2026-04-30 Improve smart shabbat switch README
2026-05-14 Move sketch into Arduino-compatible folder
